poakzmmz/NS26F-Electrical-Electronics-Part/brake-light/hardware/README.md

# Brake Light Hardware

KiCad 프로젝트 위치: `imported-source/NS26F_BrakeLight/`

- `NS26F_BrakeLight.kicad_sch`: 회로도
- `NS26F_BrakeLight.kicad_pcb`: PCB
- `NS26F_BrakeLight.kicad_pro`: 프로젝트 설정
- `production/*.zip`: 생산 파일
- `production/*_bom.csv`: BOM
- `production/*_positions.csv`: 실장 좌표
- `production/*_designators.csv`: designator 목록
- `production/netlist.ipc`: IPC netlist
