poakzmmz/NS26F-Electrical-Electronics-Part/dashboard/shiftlight/README.md

# NS26F Shift Light

WS2812B LED 12개와 74AHCT1G125를 사용하는 Shift Light PCB.

- `hardware/imported-source/RPM/`: KiCad, Gerber, BOM, 생산 파일
- `firmware/`: 현재 펌웨어 없음
