poakzmmz/NS26F-Electrical-Electronics-Part/telemetry/vehicle-node/README.md

# Vehicle Node

TTGO T3 LoRa32 V1.6.1 기반 차량 측 송신기.

- ESP32 TWAI로 EMU Black CAN Stream 수신
- CAN bitrate 500 kbps
- SX1276, 915 MHz
- 송신 펌웨어: `firmware/LoRaSender/LoRaSender.ino`
