poakzmmz/NS26F-Electrical-Electronics-Part/docs/images/portfolio/README.md

# Portfolio Images

이 폴더는 채용 포트폴리오용 실물/검증 사진을 저장합니다.

업로드 파일명:

- `datalogger_pcb_bottom.jpg` — Data Logger PCB 후면
- `datalogger_pcb_top.jpg` — Data Logger PCB 전면
- `datalogger_bench_test.jpg` — 차량 탑재 전 Bench / Integration Test
- `datalogger_vehicle_installation.jpg` — 차량 Dashboard 내부 탑재 상태
- `vehicle_harness.jpg` — 차량 Harness 제작/배선

README에서는 원본 해상도 대신 웹 표시용으로 적당히 압축한 JPEG 사용을 권장합니다.
