poakzmmz/NS26F-Electrical-Electronics-Part/dashboard/shiftlight/hardware/README.md

# Shift Light Hardware

KiCad 프로젝트 위치: `imported-source/RPM/`

- `RPM.kicad_sch`: 회로도
- `RPM.kicad_pcb`: PCB
- `RPM.kicad_pro`: 프로젝트 설정
- `RPM-*.gbr`, `RPM-job.gbrjob`: Gerber
- `production/*_bom.csv`: BOM
- `production/*_positions.csv`: 실장 좌표
- `production/*.zip`: 생산 파일
