poakzmmz/NS26F-Electrical-Electronics-Part/telemetry/receiver/firmware/README.md

# Receiver Firmware

- `LoRaReceiver/LoRaReceiver.ino`: LoRa 수신 및 Serial CSV 출력
- Arduino LoRa 라이브러리 사용
- TEAM ID가 `NS`인 FAST/SLOW 패킷 처리
