poakzmmz/NS26F-Electrical-Electronics-Part/telemetry/vehicle-node/firmware/README.md

# Vehicle Node Firmware

- `LoRaSender/LoRaSender.ino`: EMU Black CAN 데이터 LoRa 송신
- Arduino LoRa 라이브러리 사용
- FAST 패킷 200 ms 주기
- SLOW 패킷 최대 1 s heartbeat
