poakzmmz/NS26F-Electrical-Electronics-Part/dashboard/README.md

# Dashboard

- `datalogger/`: 데이터로거 하드웨어와 펌웨어
- `shiftlight/`: Shift Light 하드웨어
