poakzmmz/NS26F-Electrical-Electronics-Part/docs/README.md

# Documents

- `images/IMG_2404.JPG`: 메인 README 차량 사진
