poakzmmz/NS26F-Electrical-Electronics-Part/dashboard/display-ui/README.md

# Dashboard UI

대시보드 디스플레이 UI 파일.

- `nextion/260815_Dashboard_UI.HMI`: Nextion Editor 프로젝트
