poakzmmz/NS26F-Electrical-Electronics-Part/telemetry/receiver/README.md

# Telemetry Receiver

TTGO T3 LoRa32 V1.6.1 기반 수신기.

915 MHz LoRa 패킷을 수신해 USB Serial 115200 bps CSV로 출력한다.
