poakzmmz/NS26F-Electrical-Electronics-Part/telemetry/viewer/README.md

# Telemetry Viewer

- `lora-monitor/`: Serial 수신, Matplotlib 표시, CSV 저장
- `telemetry-dashboard/`: CSV 분석 및 실시간 웹 뷰어
