poakzmmz/NS26F-Electrical-Electronics-Part/archive/README.md

# Archive

로컬 백업용 폴더.

- `local-git-history/`: 데이터로거 펌웨어의 기존 Git 이력
- `kicad-autosave/`: KiCad 자동 저장 이력
- `local-metadata/`: macOS 메타파일

위 세 폴더는 `.gitignore`에 포함되어 있다.
