poakzmmz/NS26F-Electrical-Electronics-Part/dashboard/datalogger/firmware/stm32cubeide/Datalogger_final3/artifacts/tps_plot.png

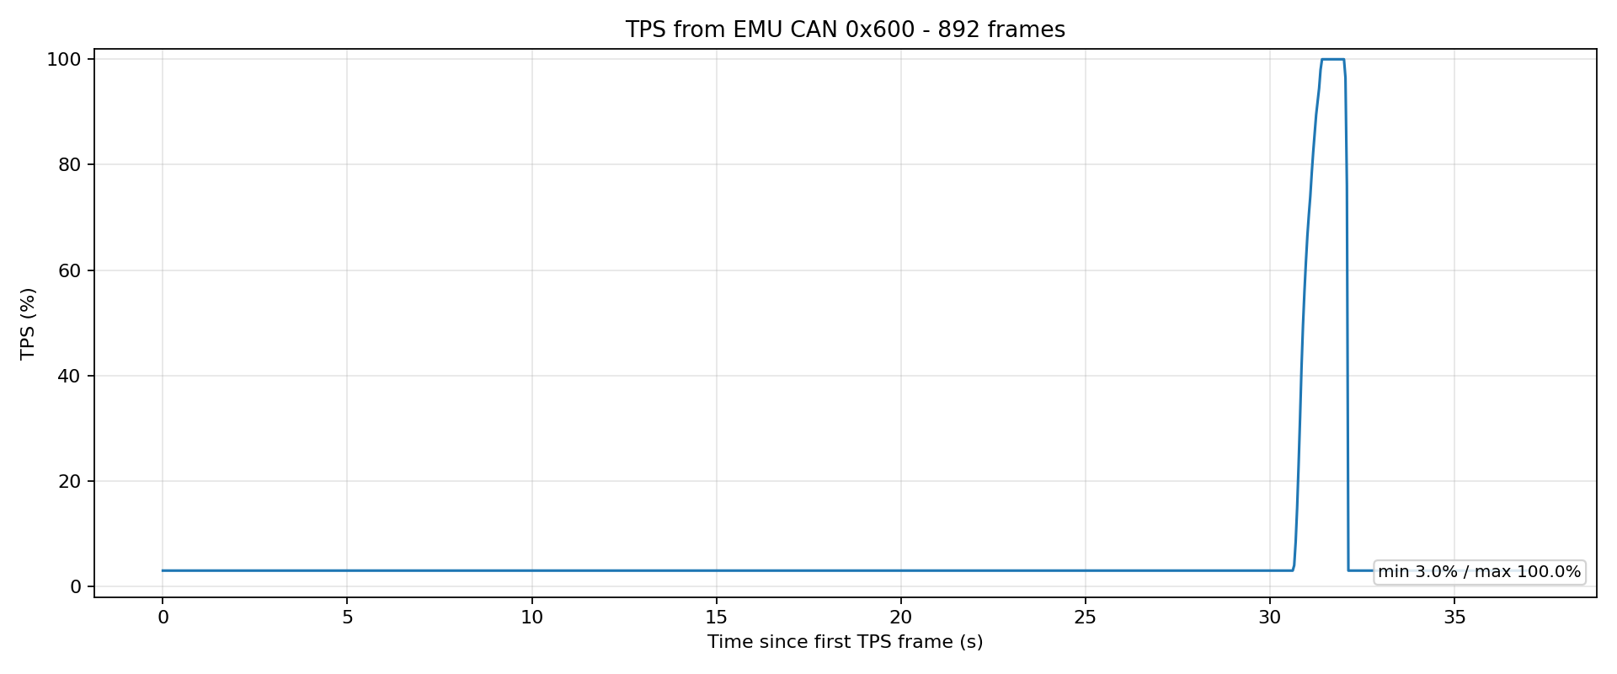
dashboard/datalogger/firmware/stm32cubeide/Datalogger_final3/artifacts/tps_plot.png
