poakzmmz/NS26F-Electrical-Electronics-Part/brake-light/hardware/imported-source/NS26F_BrakeLight/production/NS26F_BrakeLight_bom.csv

Designator | Footprint | Quantity | Value | LCSC Part #
D1, D10, D11, D12, D13, D14, D15, D16, D17, D18, D19, D2, D20, D21, D22, D23, D24, D25, D26, D27, D28, D29, D3, D30, D31, D32, D33, D34, D35, D36, D37, D38, D39, D4, D40, D41, D42, D43, D44, D45, D46, D47, D48, D49, D5, D50, D51, D52, D53, D54, D55, D56, D57, D58, D59, D6, D60, D61, D62, D63, D64, D65, D66, D67, D68, D7, D8, D9 | 0805 | 68 | LED
D69 | D_SMC | 1 | D_TVS
D70 | D_SMA | 1 | SS34
R1, R10, R11, R12, R13, R14, R15, R16, R17, R2, R3, R4, R5, R6, R7, R8, R9 | 1206 | 17 | 330
