poakzmmz/NS26F-Electrical-Electronics-Part/dashboard/datalogger/hardware/imported-source/NS26F-Datalogger-HW/TYPE-C-31-M-12--3DModel-STEP-56544.STEP

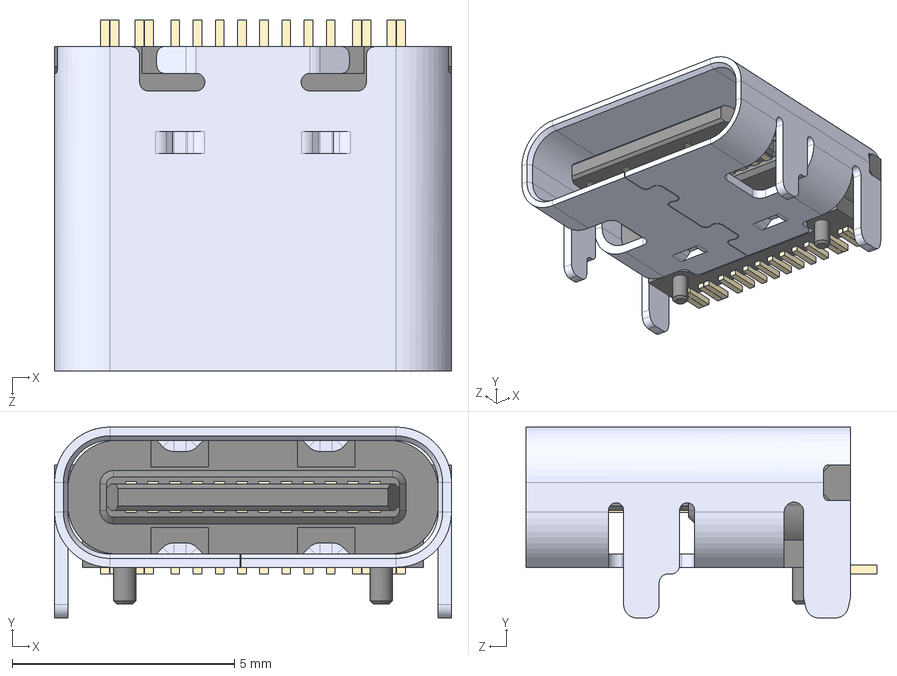
[picture p8: CAD file, 2026-08-17]
dashboard/datalogger/hardware/imported-source/NS26F-Datalogger-HW/TYPE-C-31-M-12--3DModel-STEP-56544.STEP
8.94 x 4.30 x 7.90 mm
