poakzmmz/NS26F-Electrical-Electronics-Part/dashboard/shiftlight/hardware/imported-source/RPM/.step

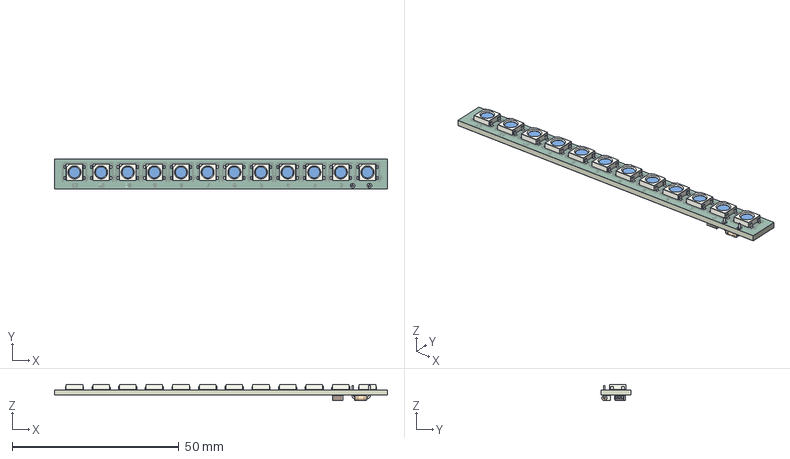
[picture p9: CAD file, 2026-08-17]
dashboard/shiftlight/hardware/imported-source/RPM/.step
100.0 x 9.00 x 4.88 mm
LED_WS2812B_PLCC4_50x50mm_P32mm x 12
R_Axial_DIN0204_L36mm_D16mm_P508mm_Horizontal
C_1206_3216Metric x 2
SOT-23-5
RPM_pad
RPM_silkscreen x 2
RPM_soldermask x 2
RPM_PCB
