poakzmmz/NS26F-Electrical-Electronics-Part/dashboard/datalogger/hardware/imported-source/NS26F-Datalogger-HW/DLTM.pdf

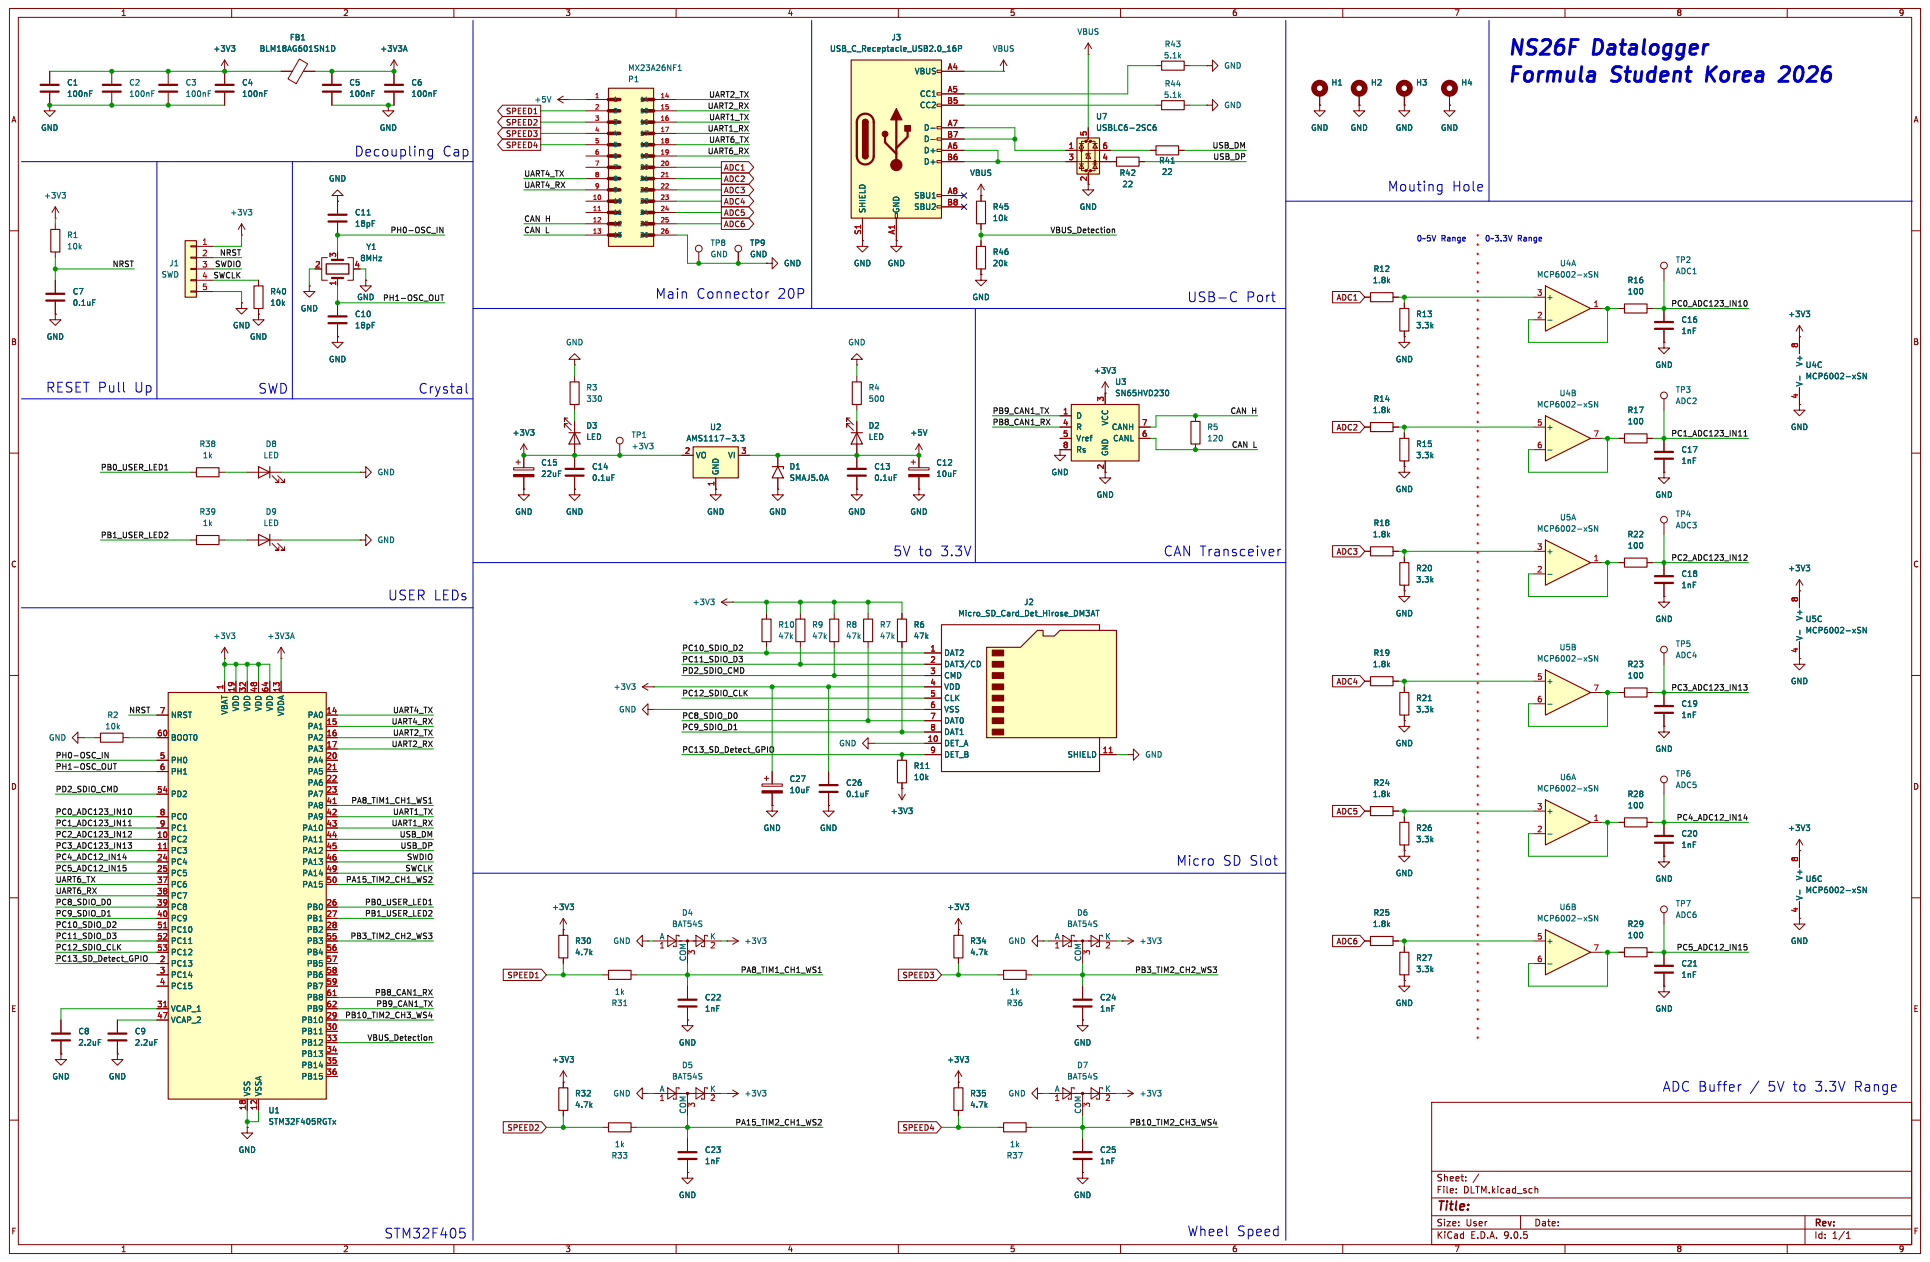
[picture p10: page 1]

1 VDD 19 VDD 32 VSS 18 VDD 48 VSSA 12 VDD 64 VDDA 13 PA0 14 PA1 15 PA2 16 PA3 17 PA4 20 PA5 21 PA6 22 PA7 23 PA8 41 PA9 42 PA10 43 PA11 44 PA12 45 PA13 46 PA14 49 PA15 50 PB0 26 PB1 27 PB2 28 PB3 55 PB4 56 PB5 57 PB6 58 PB7 59 PB8 61 PB9 62 PB10 29 PB11 30 PB12 33 PB13 34 PB14 35 PB15 36 U1STM32F405RGTx

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

ADC Buffer / 5V to 3.3V Range
