poakzmmz/NS26F-Electrical-Electronics-Part/dashboard/datalogger/hardware/imported-source/NS26F-Datalogger-HW/DLTM.kicad_pcb

## KiCad design dashboard/datalogger/hardware/imported-source/NS26F-Datalogger-HW/DLTM.kicad_pcb (2026-08-17)

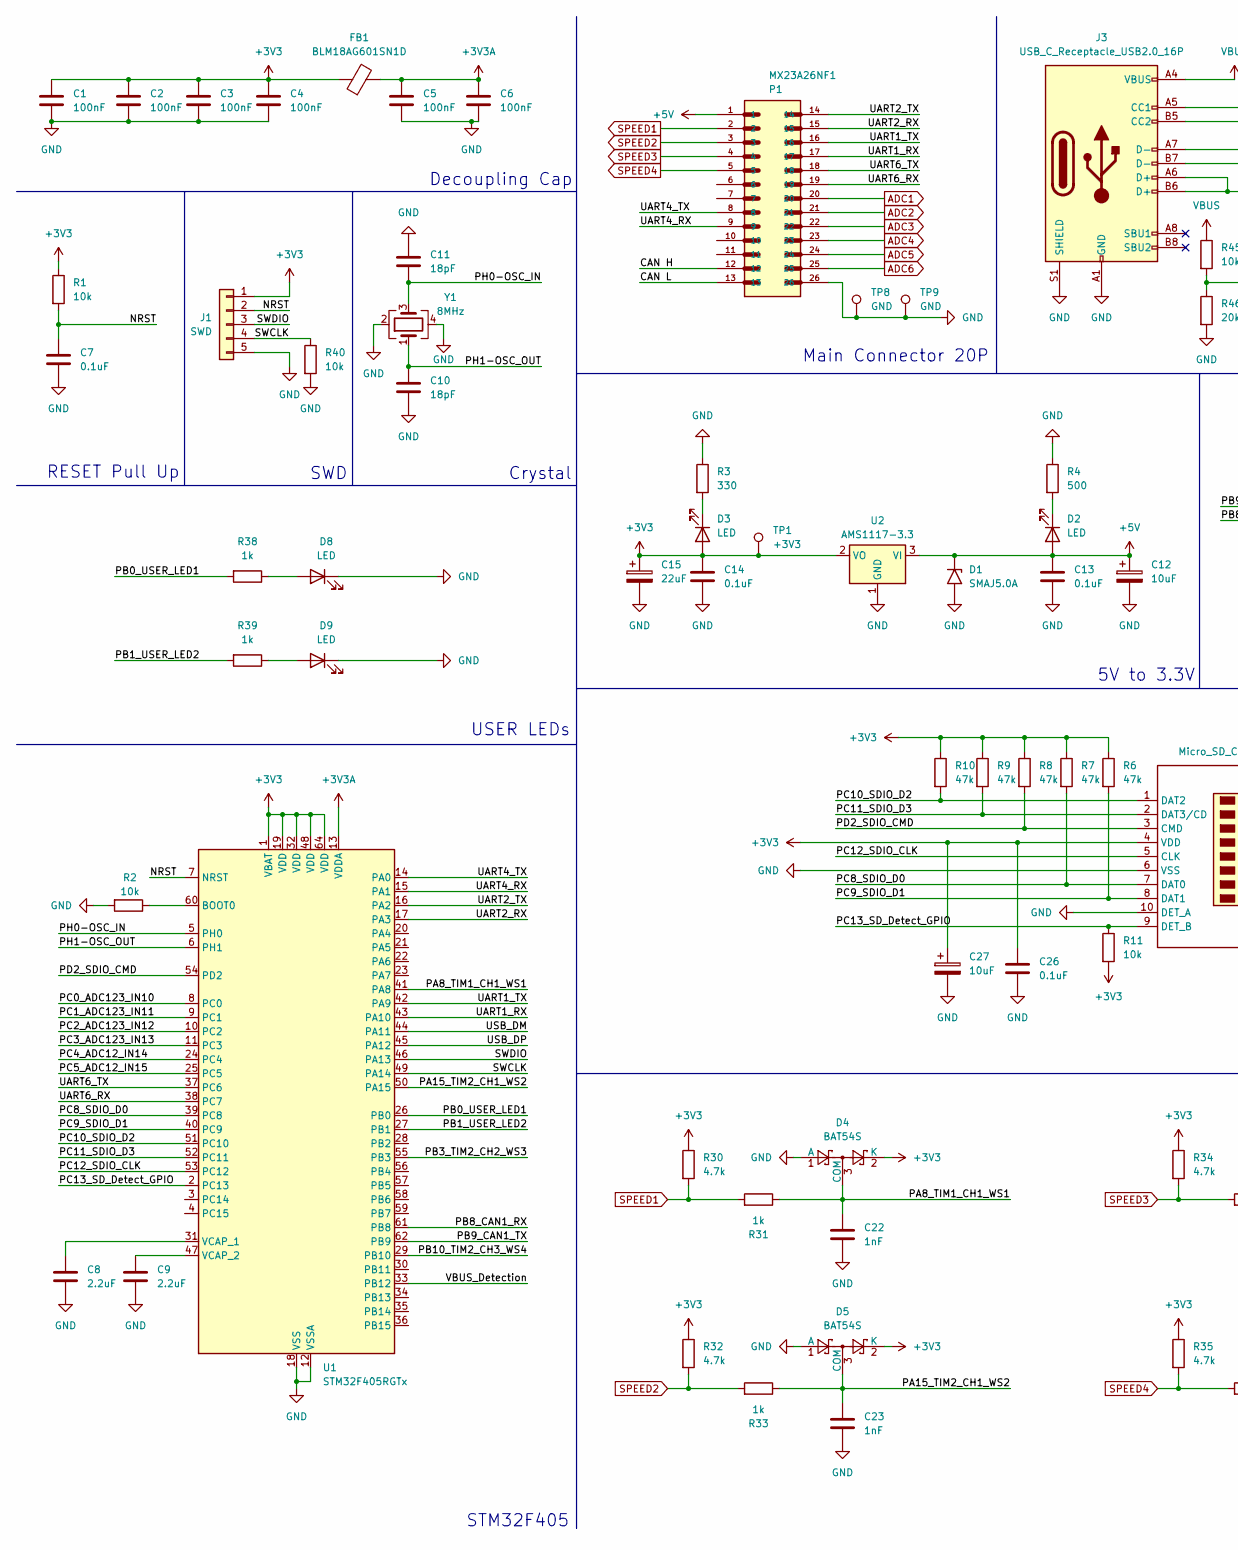
[picture p11: schematic DLTM.kicad_sch, part in row 1, column 1]

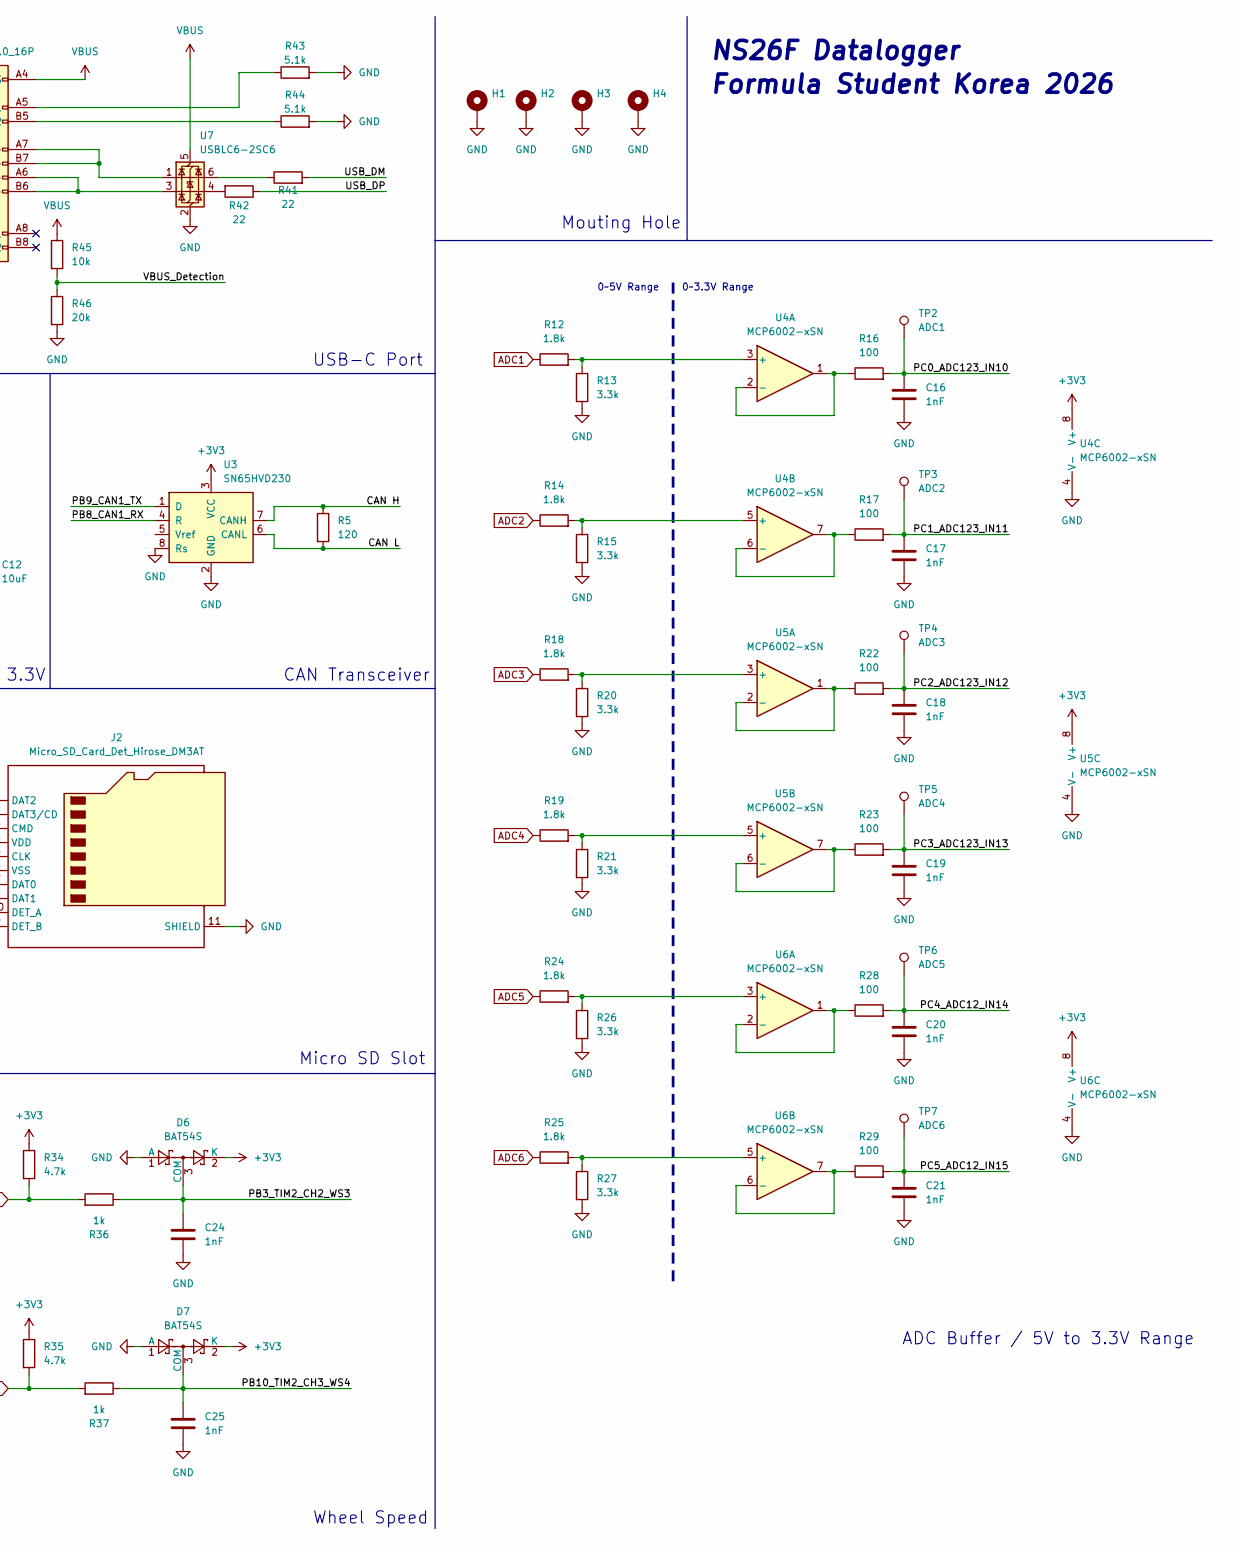
[picture p12: schematic DLTM.kicad_sch, part in row 1, column 2]

Parts:
C1, C2, C3, C4, C5, C6: 100nF; C_0603_1608Metric
C7, C13, C14, C26: 0.1uF; C_0603_1608Metric
C8, C9: 2.2uF; C_0603_1608Metric
C10, C11: 18pF; C_0603_1608Metric
C12, C27: 10uF; CP_Elec_4x5.4
C15: 22uF; CP_Elec_4x5.4
C16, C17, C18, C19, C20, C21, C22, C23, C24, C25: 1nF; C_0603_1608Metric
D1: SMAJ5.0A; D_SMA
D2, D3, D8, D9: LED; LED_0603_1608Metric
D4, D5, D6, D7: BAT54S; SOT-23
FB1: BLM18AG601SN1D; L_0603_1608Metric
H1, H2, H3, H4: MountingHole_Pad; MountingHole_3mm_Pad_TopBottom
J1: SWD; PinHeader_1x05_P2.54mm_Vertical
J2: Micro_SD_Card_Det_Hirose_DM3AT; microSD_HC_Hirose_DM3AT-SF-PEJM5
J3: USB_C_Receptacle_USB2.0_16P; USB_C_Receptacle_HRO_TYPE-C-31-M-12
P1: MX23A26NF1; JAE_MX23A26NF1
R1, R2, R11, R40, R45: 10k; R_0603_1608Metric
R3: 330; R_0603_1608Metric
R4: 500; R_0603_1608Metric
R5: 120; R_0603_1608Metric
R6, R7, R8, R9, R10: 47k; R_0603_1608Metric
R12, R14, R18, R19, R24, R25: 1.8k; R_0603_1608Metric
R13, R15, R20, R21, R26, R27: 3.3k; R_0603_1608Metric
R16, R17, R22, R23, R28, R29: 100; R_0603_1608Metric
R30, R32, R34, R35: 4.7k; R_0603_1608Metric
R31, R33, R36, R37, R38, R39: 1k; R_0603_1608Metric
R41, R42: 22; R_0603_1608Metric
R43, R44: 5.1k; R_0603_1608Metric
R46: 20k; R_0603_1608Metric
TP1: +3V3; TestPoint_Loop_D1.80mm_Drill1.0mm_Beaded
TP2: ADC1; TestPoint_Pad_1.0x1.0mm
TP3: ADC2; TestPoint_Pad_1.0x1.0mm
TP4: ADC3; TestPoint_Pad_1.0x1.0mm
TP5: ADC4; TestPoint_Pad_1.0x1.0mm
TP6: ADC5; TestPoint_Pad_1.0x1.0mm
TP7: ADC6; TestPoint_Pad_1.0x1.0mm
TP8, TP9: GND; TestPoint_Loop_D1.80mm_Drill1.0mm_Beaded
U1: STM32F405RGTx; LQFP-64_10x10mm_P0.5mm
U2: AMS1117-3.3; SOT-223-3_TabPin2
U3: SN65HVD230; SOIC-8_3.9x4.9mm_P1.27mm
U4, U5, U6: MCP6002-xSN; SOIC-8_3.9x4.9mm_P1.27mm
U7: USBLC6-2SC6; SOT-23-6
Y1: 8MHz; Crystal_SMD_3225-4Pin_3.2x2.5mm

Connections:
+3V3: C1.1, C2.1, C3.1, C4.1, C14.1, C15.1, C26.1, C27.1, D3.2 (A), D4.2 (K), D5.2 (K), D6.2 (K), D7.2 (K), FB1.1, J1.1, J2.4 (VDD), R1.1, R6.1, R7.1, R8.1, R9.1, R10.1, R11.2, R30.1, R32.1, R34.1, R35.1, TP1.1, U1.1 (VBAT), U1.19 (VDD), U1.32 (VDD), U1.48 (VDD), U1.64 (VDD), U2.2 (VO), U3.3 (VCC), U4.8 (V+), U5.8 (V+), U6.8 (V+)
+3V3A: C5.1, C6.1, FB1.2, U1.13 (VDDA)
+5V: C12.1, C13.1, D1.1 (A1), D2.2 (A), P1.1, U2.3 (VI)
/CAN H: P1.12, R5.1, U3.7 (CANH)
/CAN L: P1.13, R5.2, U3.6 (CANL)
/NRST: C7.1, J1.2, R1.2, U1.7 (NRST)
/PA8_TIM1_CH1_WS1: C22.1, D4.3 (COM), R31.1, U1.41 (PA8)
/PA15_TIM2_CH1_WS2: C23.1, D5.3 (COM), R33.1, U1.50 (PA15)
/PB0_USER_LED1: R38.2, U1.26 (PB0)
/PB1_USER_LED2: R39.2, U1.27 (PB1)
/PB3_TIM2_CH2_WS3: C24.1, D6.3 (COM), R36.1, U1.55 (PB3)
/PB8_CAN1_RX: U1.61 (PB8), U3.4 (R)
/PB9_CAN1_TX: U1.62 (PB9), U3.1 (D)
/PB10_TIM2_CH3_WS4: C25.1, D7.3 (COM), R37.1, U1.29 (PB10)
/PC0_ADC123_IN10: C16.1, R16.2, TP2.1, U1.8 (PC0)
/PC1_ADC123_IN11: C17.1, R17.2, TP3.1, U1.9 (PC1)
/PC2_ADC123_IN12: C18.1, R22.2, TP4.1, U1.10 (PC2)
/PC3_ADC123_IN13: C19.1, R23.2, TP5.1, U1.11 (PC3)
/PC4_ADC12_IN14: C20.1, R28.2, TP6.1, U1.24 (PC4)
/PC5_ADC12_IN15: C21.1, R29.2, TP7.1, U1.25 (PC5)
/PC8_SDIO_D0: J2.7 (DAT0), R7.2, U1.39 (PC8)
/PC9_SDIO_D1: J2.8 (DAT1), R6.2, U1.40 (PC9)
/PC10_SDIO_D2: J2.1 (DAT2), R10.2, U1.51 (PC10)
/PC11_SDIO_D3: J2.2 (DAT3/CD), R9.2, U1.52 (PC11)
/PC12_SDIO_CLK: J2.5 (CLK), U1.53 (PC12)
/PC13_SD_Detect_GPIO: J2.9 (DET_B), R11.1, U1.2 (PC13)
/PD2_SDIO_CMD: J2.3 (CMD), R8.2, U1.54 (PD2)
/PH0-OSC_IN: C11.2, U1.5 (PH0), Y1.3
/PH1-OSC_OUT: C10.1, U1.6 (PH1), Y1.1
/SWCLK: J1.4, R40.1, U1.49 (PA14)
/SWDIO: J1.3, U1.46 (PA13)
/UART1_RX: P1.17, U1.43 (PA10)
/UART1_TX: P1.16, U1.42 (PA9)
/UART2_RX: P1.15, U1.17 (PA3)
/UART2_TX: P1.14, U1.16 (PA2)
/UART4_RX: P1.9, U1.15 (PA1)
/UART4_TX: P1.8, U1.14 (PA0)
/UART6_RX: P1.19, U1.38 (PC7)
/UART6_TX: P1.18, U1.37 (PC6)
/USB_DM: R41.2, U1.44 (PA11)
/USB_DP: R42.1, U1.45 (PA12)
/VBUS_Detection: R45.2, R46.1, U1.33 (PB12)
ADC1: P1.20, R12.1
ADC2: P1.21, R14.1
ADC3: P1.22, R18.1
ADC4: P1.23, R19.1
ADC5: P1.24, R24.1
ADC6: P1.25, R25.1
GND: C1.2, C2.2, C3.2, C4.2, C5.2, C6.2, C7.2, C8.2, C9.2, C10.2, C11.1, C12.2, C13.2, C14.2, C15.2, C16.2, C17.2, C18.2, C19.2, C20.2, C21.2, C22.2, C23.2, C24.2, C25.2, C26.2, C27.2, D1.2 (A2), D4.1 (A), D5.1 (A), D6.1 (A), D7.1 (A), D8.1 (K), D9.1 (K), H1.1, H2.1, H3.1, H4.1, J1.5, J2.6 (VSS), J2.10 (DET_A), J2.11 (SHIELD), J3.A1 (GND), J3.A12 (GND), J3.B1 (GND), J3.B12 (GND), J3.S1 (SHIELD), P1.26, R2.2, R3.1, R4.1, R13.2, R15.2, R20.2, R21.2, R26.2, R27.2, R40.2, R43.2, R44.2, R46.2, TP8.1, TP9.1, U1.12 (VSSA), U1.18 (VSS), U1.63 (VSS), U2.1 (GND), U3.2 (GND), U3.8 (Rs), U4.4 (V-), U5.4 (V-), U6.4 (V-), U7.2 (GND), Y1.2, Y1.4
unnamed: D2.1 (K), R4.2
unnamed: D3.1 (K), R3.2
unnamed: D8.2 (A), R38.1
unnamed: D9.2 (A), R39.1
unnamed: J3.A5 (CC1), R43.1
unnamed: J3.B5 (CC2), R44.1
unnamed: J3.A6 (D+), J3.B6 (D+), U7.3 (I/O2)
unnamed: J3.A7 (D-), J3.B7 (D-), U7.1 (I/O1)
unnamed: R41.1, U7.6 (I/O1)
unnamed: R42.2, U7.4 (I/O2)
unnamed: R2.1, U1.60 (BOOT0)
unnamed: C8.1, U1.31 (VCAP_1)
unnamed: C9.1, U1.47 (VCAP_2)
unnamed: R12.2, R13.1, U4.3 (+)
unnamed: R16.1, U4.1, U4.2 (-)
unnamed: R14.2, R15.1, U4.5 (+)
unnamed: R17.1, U4.6 (-), U4.7
unnamed: R18.2, R20.1, U5.3 (+)
unnamed: R22.1, U5.1, U5.2 (-)
unnamed: R19.2, R21.1, U5.5 (+)
unnamed: R23.1, U5.6 (-), U5.7
unnamed: R24.2, R26.1, U6.3 (+)
unnamed: R28.1, U6.1, U6.2 (-)
unnamed: R25.2, R27.1, U6.5 (+)
unnamed: R29.1, U6.6 (-), U6.7
SPEED1: P1.2, R30.2, R31.2
SPEED2: P1.3, R32.2, R33.2
SPEED3: P1.4, R34.2, R36.2
SPEED4: P1.5, R35.2, R37.2
VBUS: J3.A4 (VBUS), J3.A9 (VBUS), J3.B4 (VBUS), J3.B9 (VBUS), R45.1, U7.5 (VBUS)

Notes on the sheet:
0~3.3V Range
USB-C Port
Main Connector 20P
STM32F405
Decoupling Cap
USER LEDs
Mouting Hole
NS26F Datalogger
Micro SD Slot
CAN Transceiver
Formula Student Korea 2026
RESET Pull Up
Wheel Speed
5V to 3.3V
ADC Buffer / 5V to 3.3V Range
Crystal
SWD
0~5V Range

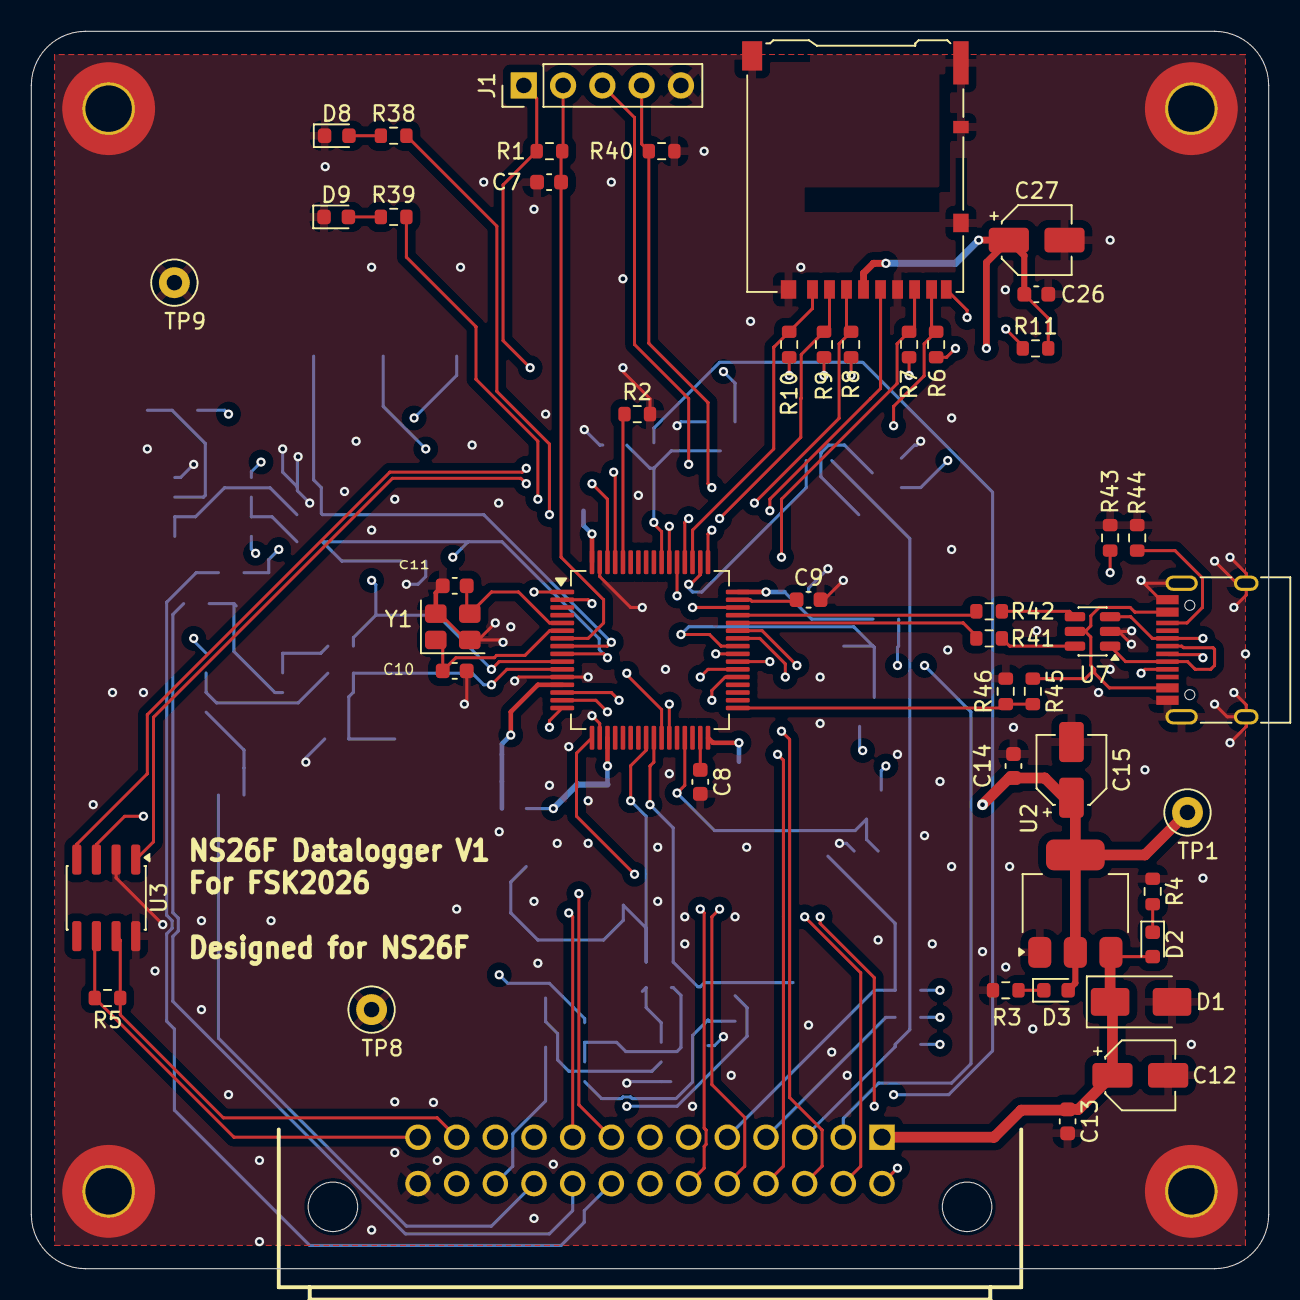
[picture p13: board DLTM.kicad_pcb from above]

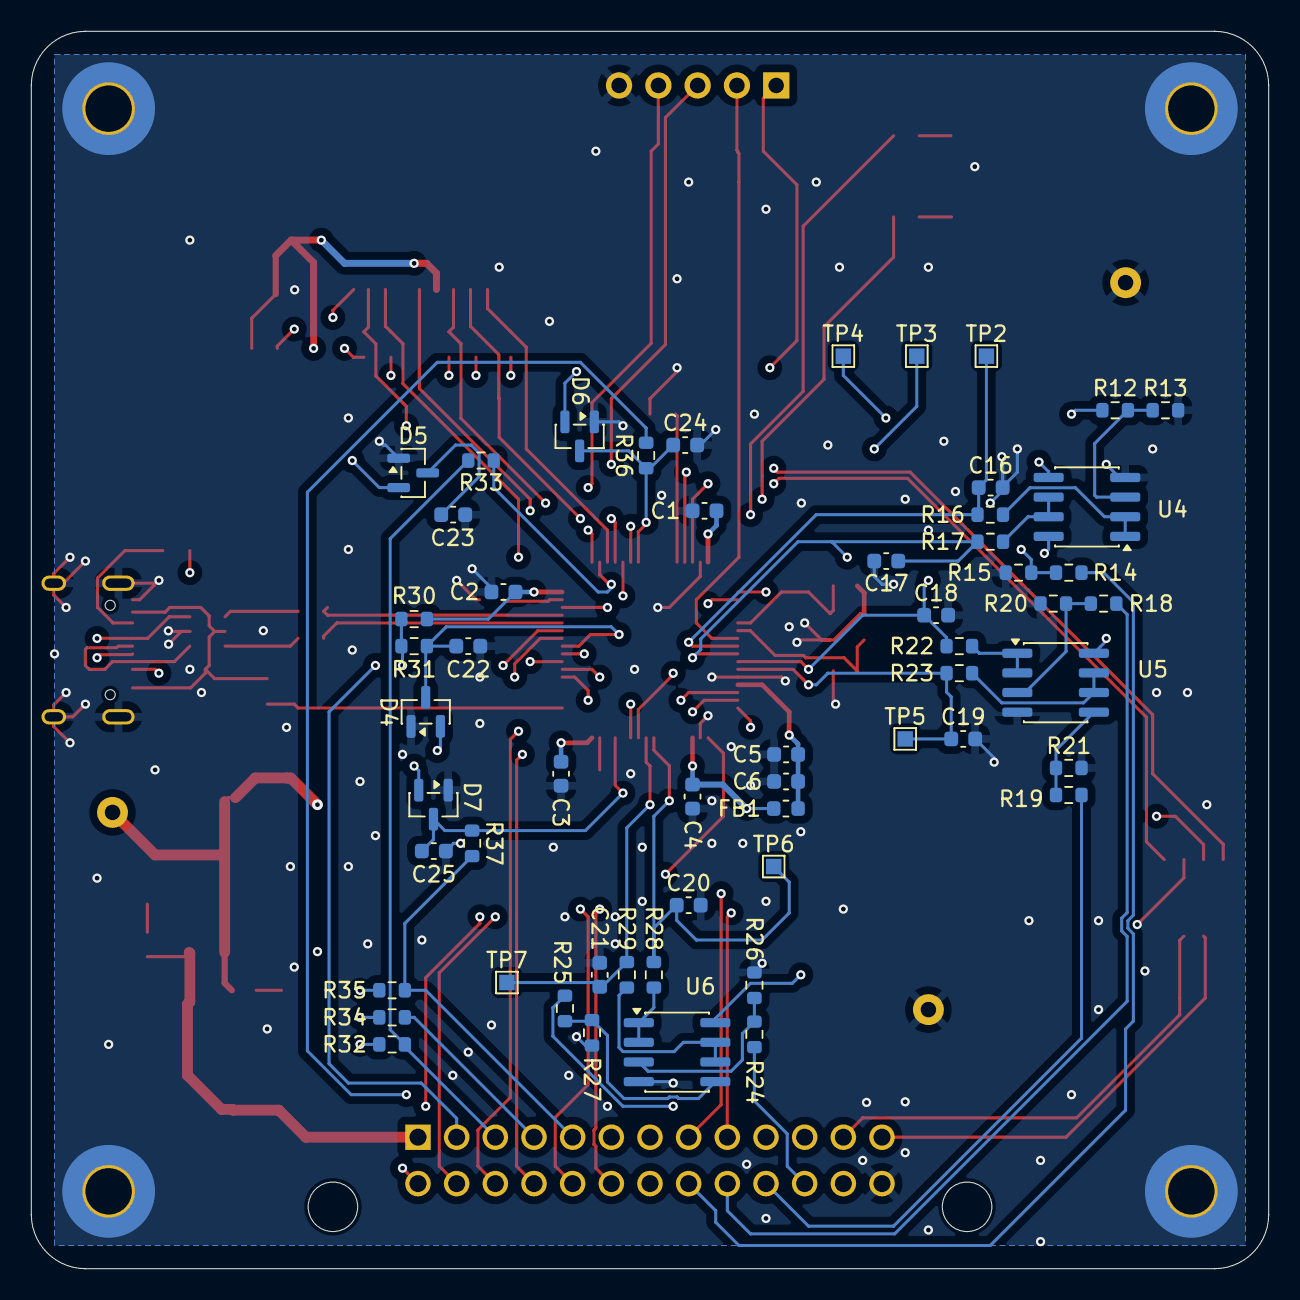
[picture p14: board DLTM.kicad_pcb from below]

Board: 4 copper layers, 80.0 x 80.0 mm, 108 parts (56 on the bottom side), 79 nets.
