poakzmmz/NS26F-Electrical-Electronics-Part/brake-light/hardware/imported-source/NS26F_BrakeLight/NS26F_BrakeLight.kicad_pcb

## KiCad design brake-light/hardware/imported-source/NS26F_BrakeLight/NS26F_BrakeLight.kicad_pcb (2026-08-17)

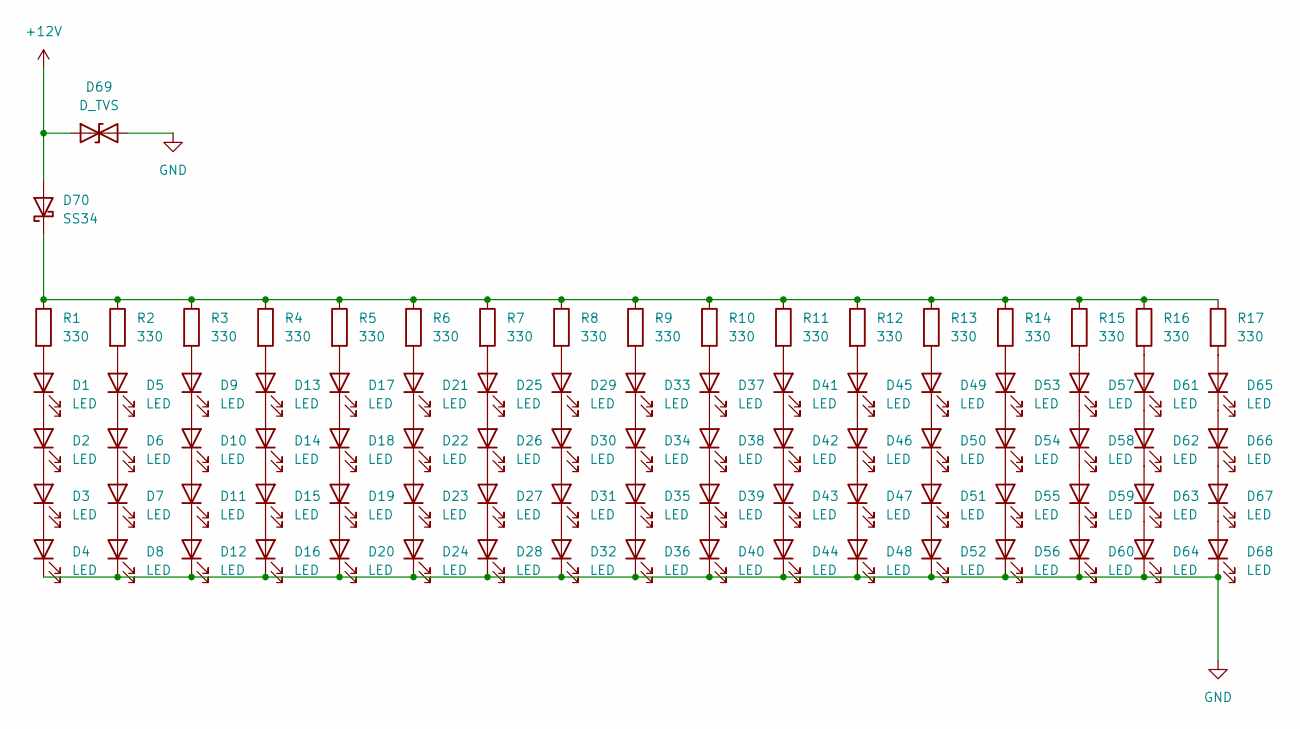
[picture p15: schematic NS26F_BrakeLight.kicad_sch]

Parts:
D1, D2, D3, D4, D5, D6, D7, D8, D9, D10, D11, D12, D13, D14, D15, D16, D17, D18, D19, D20, D21, D22, D23, D24, D25, D26, D27, D28, D29, D30, D31, D32, D33, D34, D35, D36, D37, D38, D39, D40, D41, D42, D43, D44, D45, D46, D47, D48, D49, D50, D51, D52, D53, D54, D55, D56, D57, D58, D59, D60, D61, D62, D63, D64, D65, D66, D67, D68: LED; LED_0805_2012Metric_Pad1.15x1.40mm_HandSolder
D69: D_TVS; D_SMC
D70: SS34; D_SMA
R1, R2, R3, R4, R5, R6, R7, R8, R9, R10, R11, R12, R13, R14, R15, R16, R17: 330; R_1206_3216Metric_Pad1.30x1.75mm_HandSolder

Connections:
+12V: D69.1 (A1), D70.2 (A); also elsewhere on the board
GND: D4.1 (K), D8.1 (K), D12.1 (K), D16.1 (K), D20.1 (K), D24.1 (K), D28.1 (K), D32.1 (K), D36.1 (K), D40.1 (K), D44.1 (K), D48.1 (K), D52.1 (K), D56.1 (K), D60.1 (K), D64.1 (K), D68.1 (K), D69.2 (A2); also elsewhere on the board
unnamed: D1.2 (A), R1.2
unnamed: D1.1 (K), D2.2 (A)
unnamed: D2.1 (K), D3.2 (A)
unnamed: D3.1 (K), D4.2 (A)
unnamed: D5.2 (A), R2.2
unnamed: D5.1 (K), D6.2 (A)
unnamed: D6.1 (K), D7.2 (A)
unnamed: D7.1 (K), D8.2 (A)
unnamed: D9.2 (A), R3.2
unnamed: D9.1 (K), D10.2 (A)
unnamed: D10.1 (K), D11.2 (A)
unnamed: D11.1 (K), D12.2 (A)
unnamed: D13.2 (A), R4.2
unnamed: D13.1 (K), D14.2 (A)
unnamed: D14.1 (K), D15.2 (A)
unnamed: D15.1 (K), D16.2 (A)
unnamed: D17.2 (A), R5.2
unnamed: D17.1 (K), D18.2 (A)
unnamed: D18.1 (K), D19.2 (A)
unnamed: D19.1 (K), D20.2 (A)
unnamed: D21.2 (A), R6.2
unnamed: D21.1 (K), D22.2 (A)
unnamed: D22.1 (K), D23.2 (A)
unnamed: D23.1 (K), D24.2 (A)
unnamed: D25.2 (A), R7.2
unnamed: D25.1 (K), D26.2 (A)
unnamed: D26.1 (K), D27.2 (A)
unnamed: D27.1 (K), D28.2 (A)
unnamed: D29.2 (A), R8.2
unnamed: D29.1 (K), D30.2 (A)
unnamed: D30.1 (K), D31.2 (A)
unnamed: D31.1 (K), D32.2 (A)
unnamed: D33.2 (A), R9.2
unnamed: D33.1 (K), D34.2 (A)
unnamed: D34.1 (K), D35.2 (A)
unnamed: D35.1 (K), D36.2 (A)
unnamed: D37.2 (A), R10.2
unnamed: D37.1 (K), D38.2 (A)
unnamed: D38.1 (K), D39.2 (A)
unnamed: D39.1 (K), D40.2 (A)
unnamed: D41.2 (A), R11.2
unnamed: D41.1 (K), D42.2 (A)
unnamed: D42.1 (K), D43.2 (A)
unnamed: D43.1 (K), D44.2 (A)
unnamed: D45.2 (A), R12.2
unnamed: D45.1 (K), D46.2 (A)
unnamed: D46.1 (K), D47.2 (A)
unnamed: D47.1 (K), D48.2 (A)
unnamed: D49.2 (A), R13.2
unnamed: D49.1 (K), D50.2 (A)
unnamed: D50.1 (K), D51.2 (A)
unnamed: D51.1 (K), D52.2 (A)
unnamed: D53.2 (A), R14.2
unnamed: D53.1 (K), D54.2 (A)
unnamed: D54.1 (K), D55.2 (A)
unnamed: D55.1 (K), D56.2 (A)
unnamed: D57.2 (A), R15.2
unnamed: D57.1 (K), D58.2 (A)
unnamed: D58.1 (K), D59.2 (A)
unnamed: D59.1 (K), D60.2 (A)
unnamed: D61.2 (A), R16.2
unnamed: D61.1 (K), D62.2 (A)
unnamed: D62.1 (K), D63.2 (A)
unnamed: D63.1 (K), D64.2 (A)
unnamed: D65.2 (A), R17.2
unnamed: D65.1 (K), D66.2 (A)
unnamed: D66.1 (K), D67.2 (A)
unnamed: D67.1 (K), D68.2 (A)
unnamed: D70.1 (K), R1.1, R2.1, R3.1, R4.1, R5.1, R6.1, R7.1, R8.1, R9.1, R10.1, R11.1, R12.1, R13.1, R14.1, R15.1, R16.1, R17.1

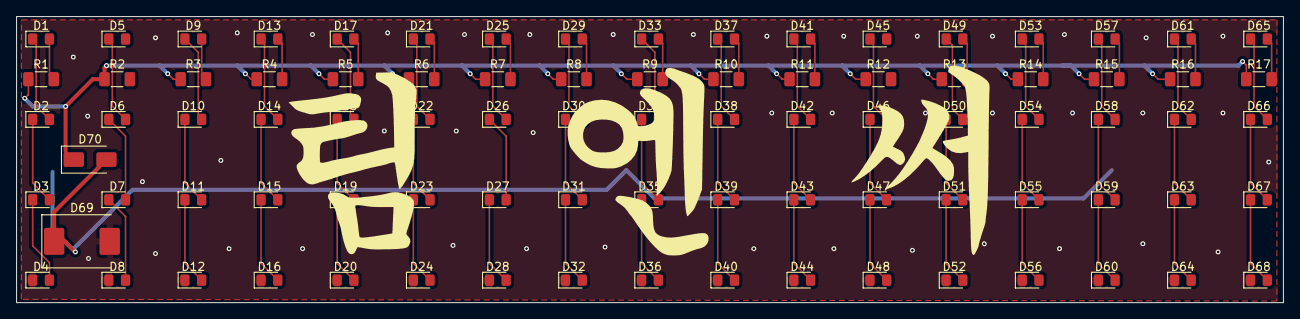
[picture p16: board NS26F_BrakeLight.kicad_pcb from above]

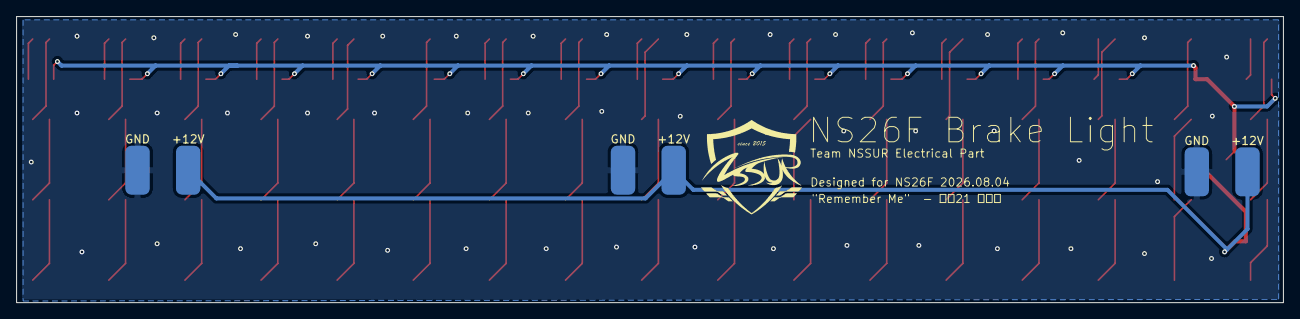
[picture p17: board NS26F_BrakeLight.kicad_pcb from below]

Board: 2 copper layers, 155.0 x 35.0 mm, 93 parts (6 on the bottom side), 71 nets.

Other parts of the board:
+12V, +12V#2, +12V#3: SolderWirePad_1x01_SMD_3x6mm
GND: SolderWirePad_1x01_SMD_3x6mm
GND#2, GND#3: SolderWirePad_1x01_SMD_3x6mm

Their connections:
+12V: +12V.1, +12V#2.1, +12V#3.1; also elsewhere on the board
GND: GND.1, GND#2.1, GND#3.1; also elsewhere on the board
