poakzmmz/NS26F-Electrical-Electronics-Part/dashboard/shiftlight/hardware/imported-source/RPM/RPM.kicad_pcb

## KiCad design dashboard/shiftlight/hardware/imported-source/RPM/RPM.kicad_pcb (2026-08-17)

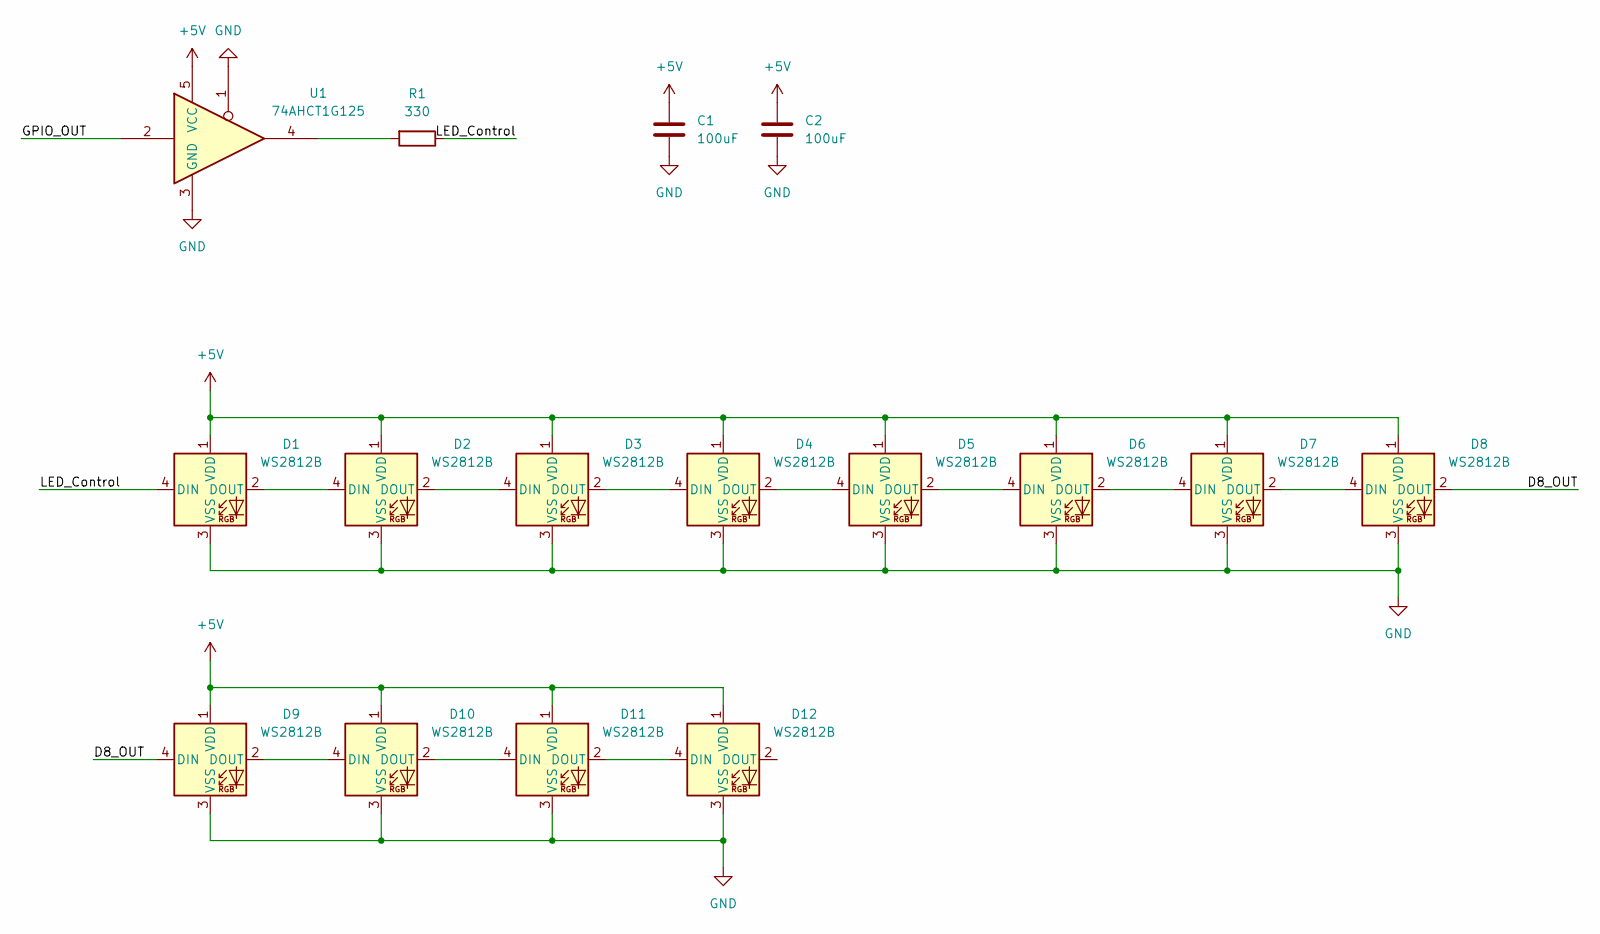
[picture p18: schematic RPM.kicad_sch]

Parts:
C1, C2: 100uF; C_1206_3216Metric_Pad1.33x1.80mm_HandSolder
D1, D2, D3, D4, D5, D6, D7, D8, D9, D10, D11, D12: WS2812B; LED_WS2812B_PLCC4_5.0x5.0mm_P3.2mm
R1: 330; R_0805_2012Metric_Pad1.20x1.40mm_HandSolder
U1: 74AHCT1G125; SOT-23-5_HandSoldering

Connections:
+5V: C1.1, C2.1, D1.1 (VDD), D2.1 (VDD), D3.1 (VDD), D4.1 (VDD), D5.1 (VDD), D6.1 (VDD), D7.1 (VDD), D8.1 (VDD), D9.1 (VDD), D10.1 (VDD), D11.1 (VDD), D12.1 (VDD), U1.5 (VCC)
/D8_OUT: D8.2 (DOUT), D9.4 (DIN)
/GPIO_OUT: U1.2
/LED_Control: D1.4 (DIN), R1.1
GND: C1.2, C2.2, D1.3 (VSS), D2.3 (VSS), D3.3 (VSS), D4.3 (VSS), D5.3 (VSS), D6.3 (VSS), D7.3 (VSS), D8.3 (VSS), D9.3 (VSS), D10.3 (VSS), D11.3 (VSS), D12.3 (VSS), U1.1, U1.3 (GND)
unnamed: D1.2 (DOUT), D2.4 (DIN)
unnamed: D2.2 (DOUT), D3.4 (DIN)
unnamed: D3.2 (DOUT), D4.4 (DIN)
unnamed: D4.2 (DOUT), D5.4 (DIN)
unnamed: D5.2 (DOUT), D6.4 (DIN)
unnamed: D6.2 (DOUT), D7.4 (DIN)
unnamed: D7.2 (DOUT), D8.4 (DIN)
unnamed: D9.2 (DOUT), D10.4 (DIN)
unnamed: D10.2 (DOUT), D11.4 (DIN)
unnamed: D11.2 (DOUT), D12.4 (DIN)
unnamed: R1.2, U1.4

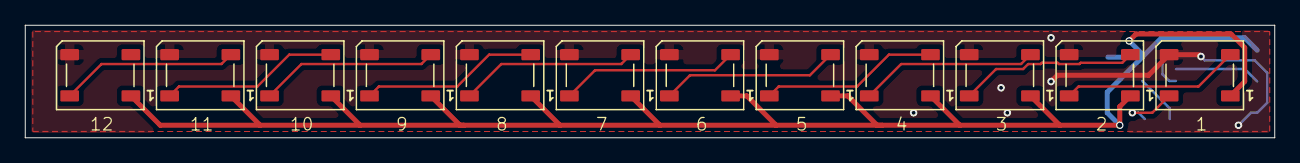
[picture p19: board RPM.kicad_pcb from above]

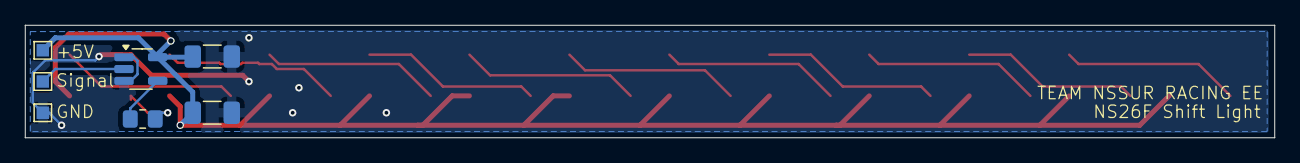
[picture p20: board RPM.kicad_pcb from below]

Board: 2 copper layers, 100.0 x 9.0 mm, 16 parts (4 on the bottom side), 15 nets.
