poakzmmz/NS26F-Electrical-Electronics-Part/dashboard/datalogger/firmware/stm32cubeide/Datalogger_final3/Datalogger_test.ioc

Mcu.UserName=STM32F405RGTx
PA0-WKUP.Signal=UART4_TX
PA1.Signal=UART4_RX
PA10.Signal=USART1_RX
PA11.Signal=USB_OTG_FS_DM
PA12.Signal=USB_OTG_FS_DP
PA13.Signal=SYS_JTMS-SWDIO
PA14.Signal=SYS_JTCK-SWCLK
PA15.Signal=S_TIM2_CH1_ETR
PA2.Signal=USART2_TX
PA3.Signal=USART2_RX
PA8.Signal=S_TIM1_CH1
PA9.Signal=USART1_TX
PC7.Signal=USART6_RX
PB0.GPIO_Label=USER_LED_0
PB0.Signal=GPIO_Output
PB1.GPIO_Label=USER_LED_1
PB1.Signal=GPIO_Output
PB10.Signal=S_TIM2_CH3
PB12.GPIO_Label=VBUS_Detection
PB12.Signal=GPIO_Input
PB3.Signal=S_TIM2_CH2
PB8.Signal=CAN1_RX
PB9.Signal=CAN1_TX
PC0.Signal=ADCx_IN10
PC1.Signal=ADCx_IN11
PC10.Signal=SDIO_D2
PC11.Signal=SDIO_D3
PC12.Signal=SDIO_CK
PC13-ANTI_TAMP.GPIO_Label=SD_Detect
PC13-ANTI_TAMP.Signal=GPIO_Input
PC2.Signal=ADCx_IN12
PC3.Signal=ADCx_IN13
PC4.Signal=ADCx_IN14
PC5.Signal=ADCx_IN15
PC6.Signal=S_TIM8_CH1
PC8.Signal=SDIO_D0
PC9.Signal=SDIO_D1
PD2.Signal=SDIO_CMD
PH0-OSC_IN.Signal=RCC_OSC_IN
PH1-OSC_OUT.Signal=RCC_OSC_OUT
