poakzmmz/NS26F-Electrical-Electronics-Part/(commit log)

2026-08-17 Initial public release
    [.step, DLTM.kicad_pcb, DLTM.kicad_sch, DLTM_Old.kicad_pcb, NS26F_BrakeLight.kicad_pcb, NS26F_BrakeLight.kicad_sch, NS26F_BrakeLight_V2_bom.csv, NS26F_BrakeLight_V2_designators.csv]
2026-10-16 refactor: modularize datalogger firmware
    * refactor: add shared datalogger internal interface
    * refactor: split can_bus module
    * refactor: split dashboard module
    * refactor: split telemetry module
    * refactor: split wheel_speed module
    * refactor: split imu module
    * refactor: split gnss module
    * refactor: split sd_logger module
    * refactor: split adc_input module
    * refactor: split shiftlight module
    * refactor: split app_callbacks module
    * refactor: split led_diag module
    * refactor: reduce main to initialization and scheduling
    * refactor: move application state out of main
    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
