poakzmmz/NS26F-Electrical-Electronics-Part/(notices)

Notices in the files:
dashboard/datalogger/firmware/stm32cubeide/Datalogger_final3/Core/Src/main.c:
Copyright (c) 2026 STMicroelectronics.
All rights reserved.
This software is licensed under terms that can be found in the LICENSE file
